printsmith/Greenwood18N2/README.md

# SP-110 Duo
Custom keyboard featuring a modified Southpaw 1800 layout with 2 nav clusters, LCD display and rotary encoders.
