printsmith/Greenwood18N2/SP110duo/dev/b2f16a65f4e9bf5dfcba937e58a7501a033d6607_switch.dxf

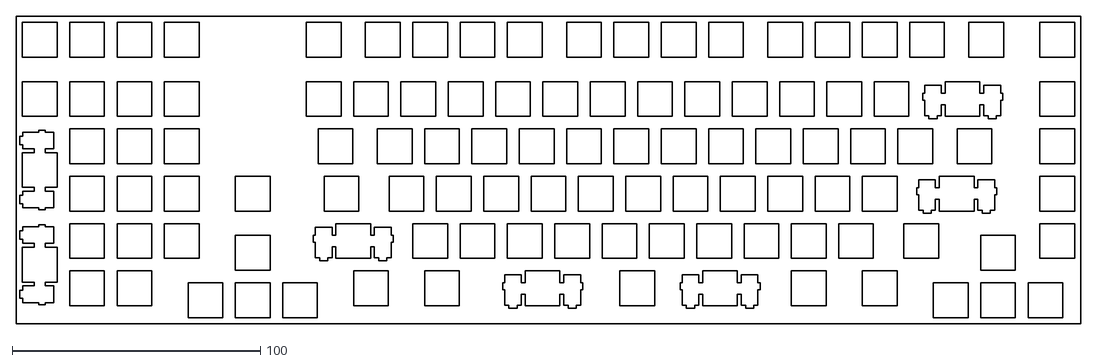
[picture p1: CAD file, 2023-11-25]
SP110duo/dev/b2f16a65f4e9bf5dfcba937e58a7501a033d6607_switch.dxf
428.6 x 123.8
