printsmith/Greenwood18N2/SP110duo/dev/CAD/plate.dxf

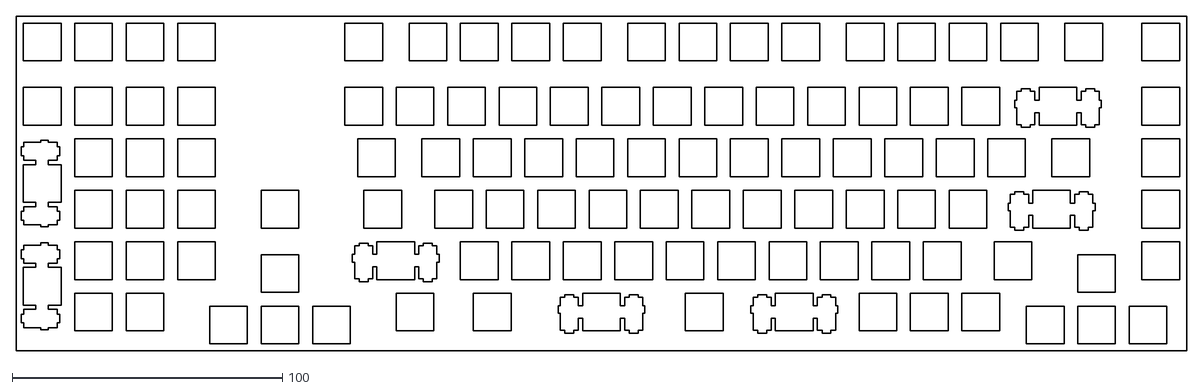
[picture p2: CAD file, 2023-12-18]
SP110duo/dev/CAD/plate.dxf
433.4 x 123.8
