printsmith/Greenwood18N2/SP110duo/dev/CAD/plate/plate-2023-11-30T22_32_08.672Z.dxf

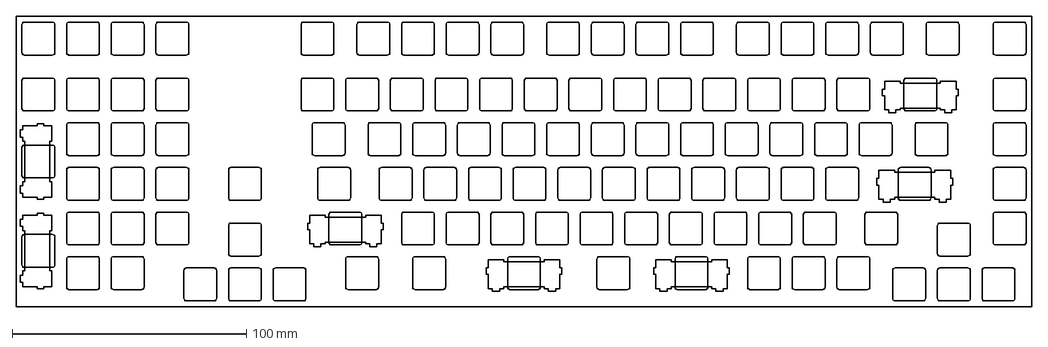
[picture p3: CAD file, 2023-12-18]
SP110duo/dev/CAD/plate/plate-2023-11-30T22_32_08.672Z.dxf
433.4 x 123.8 mm
