printsmith/Greenwood18N2/SP110duo/v1/SP110Duo.kicad_sch

## KiCad design SP110duo/v1/SP110Duo.kicad_sch (2024-02-24)

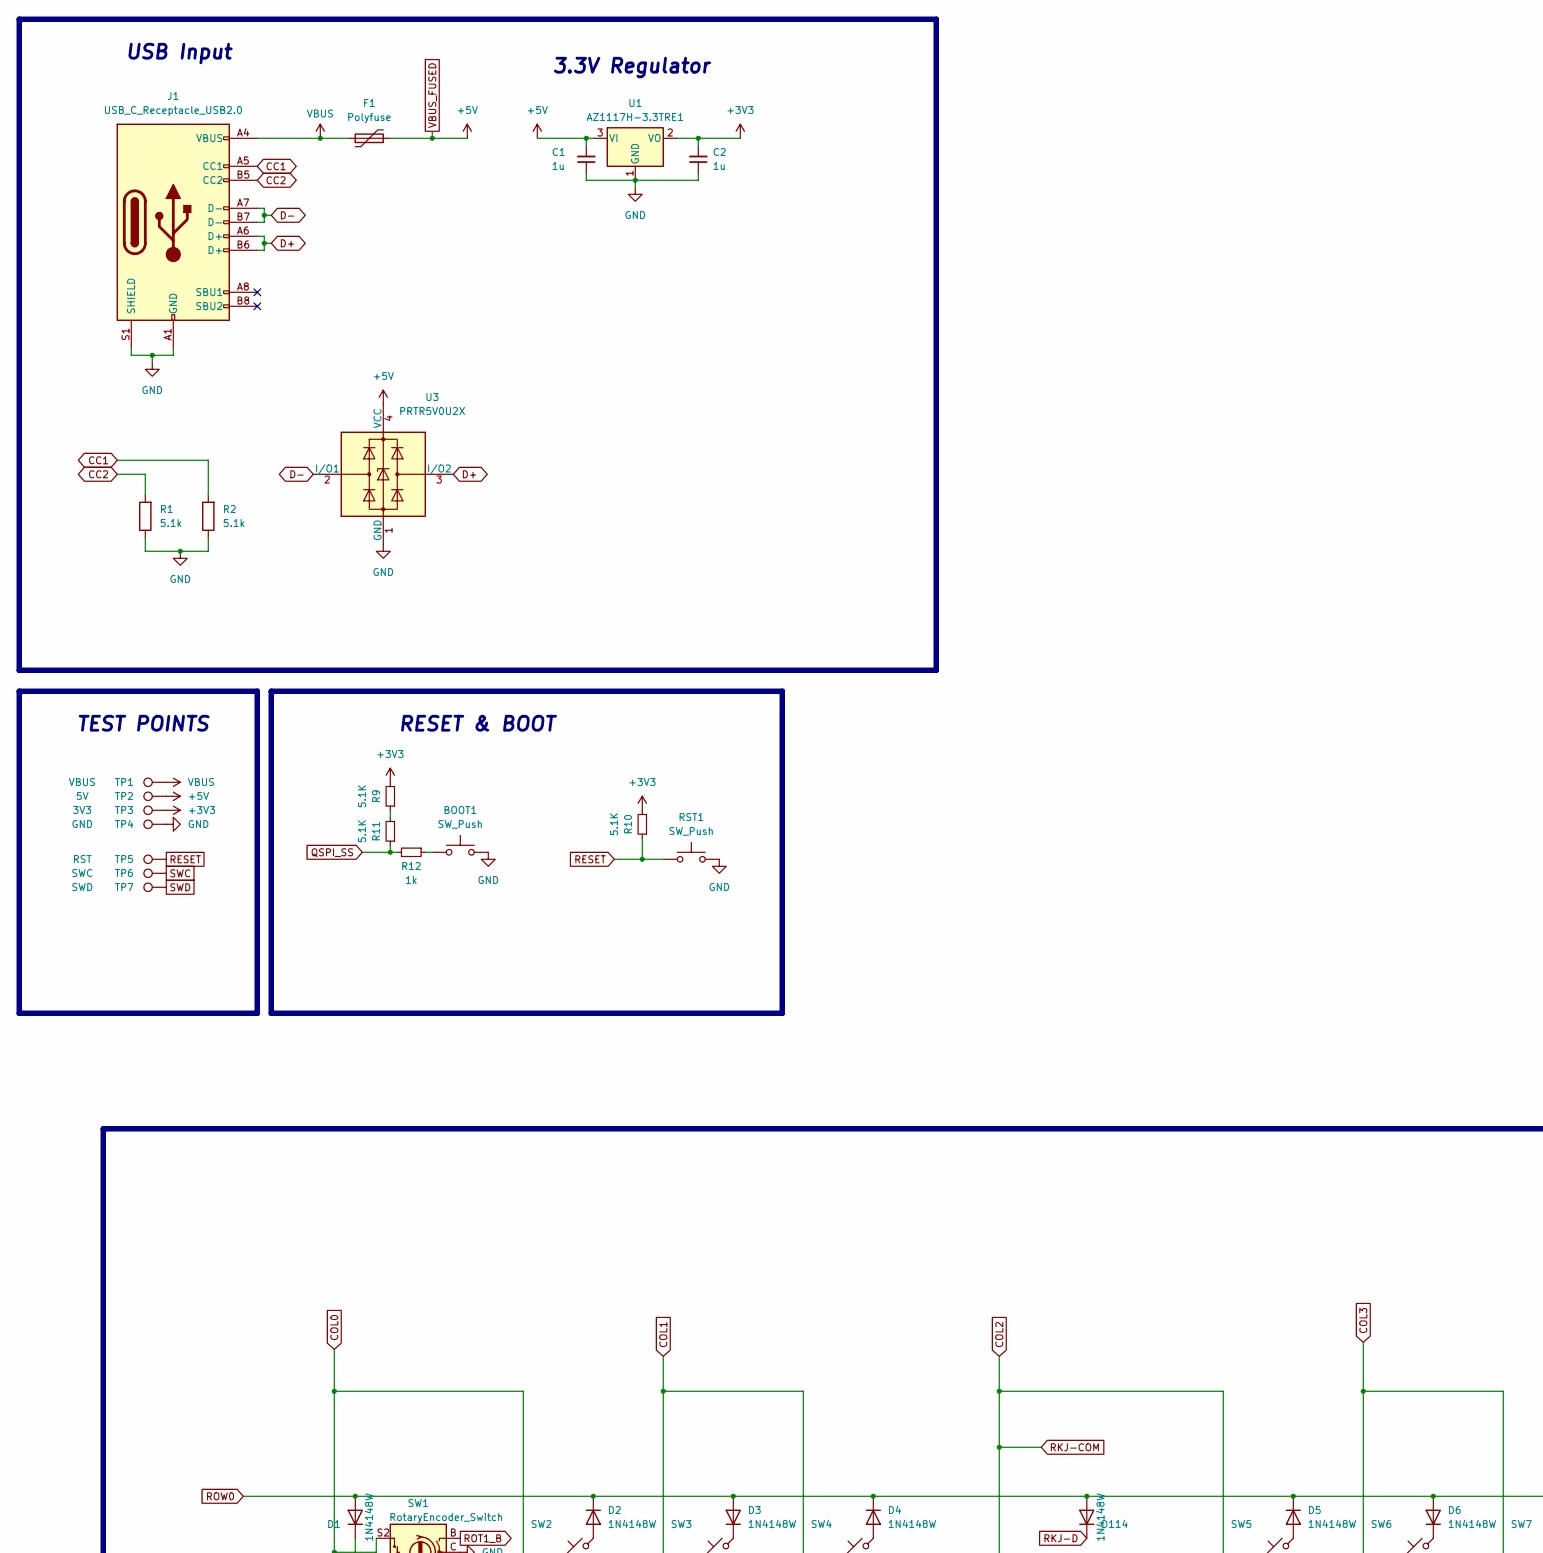
[picture p8: schematic SP110Duo.kicad_sch, part in row 1, column 1]

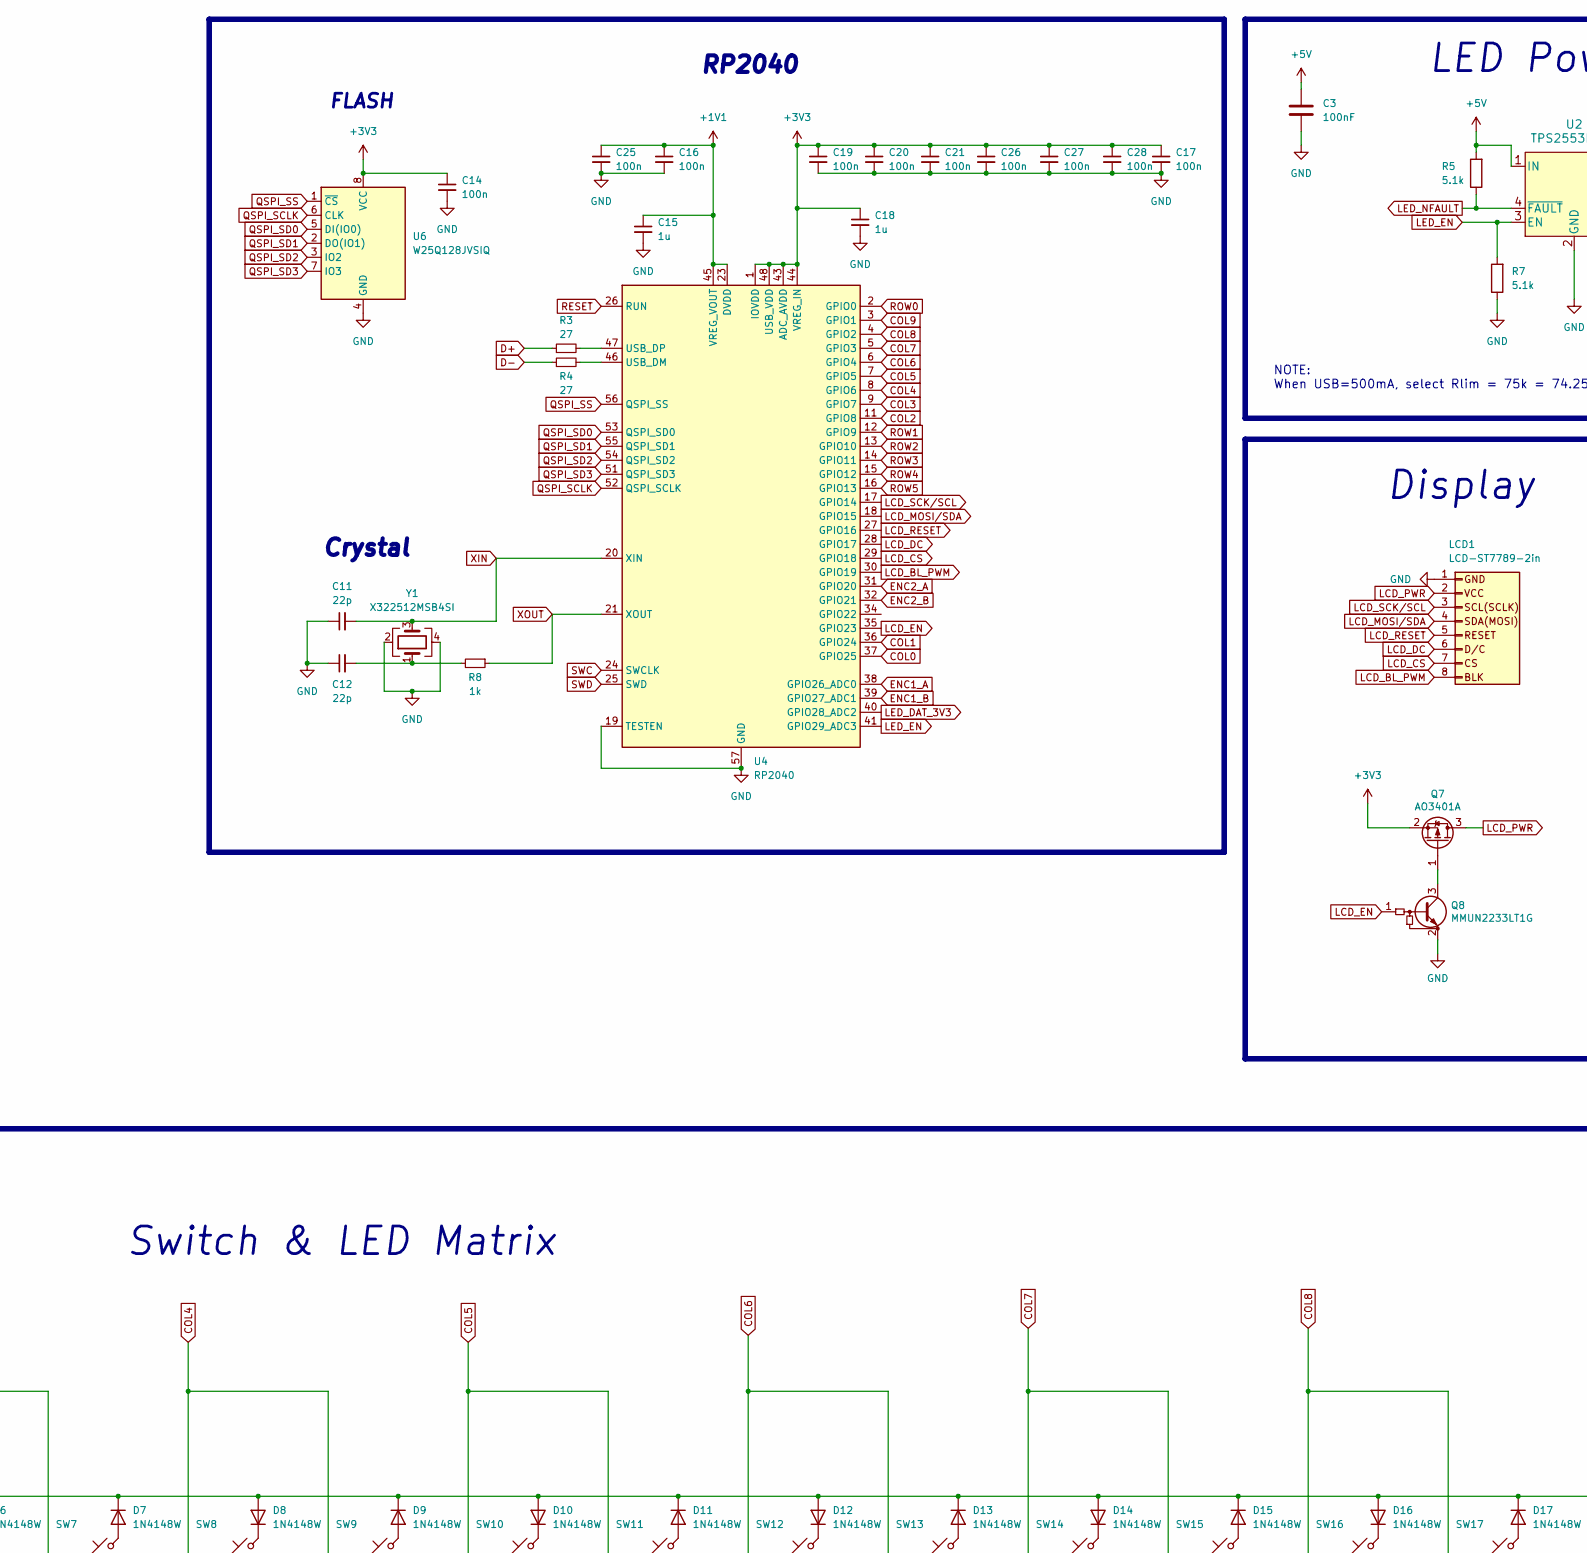
[picture p9: schematic SP110Duo.kicad_sch, part in row 1, column 2]

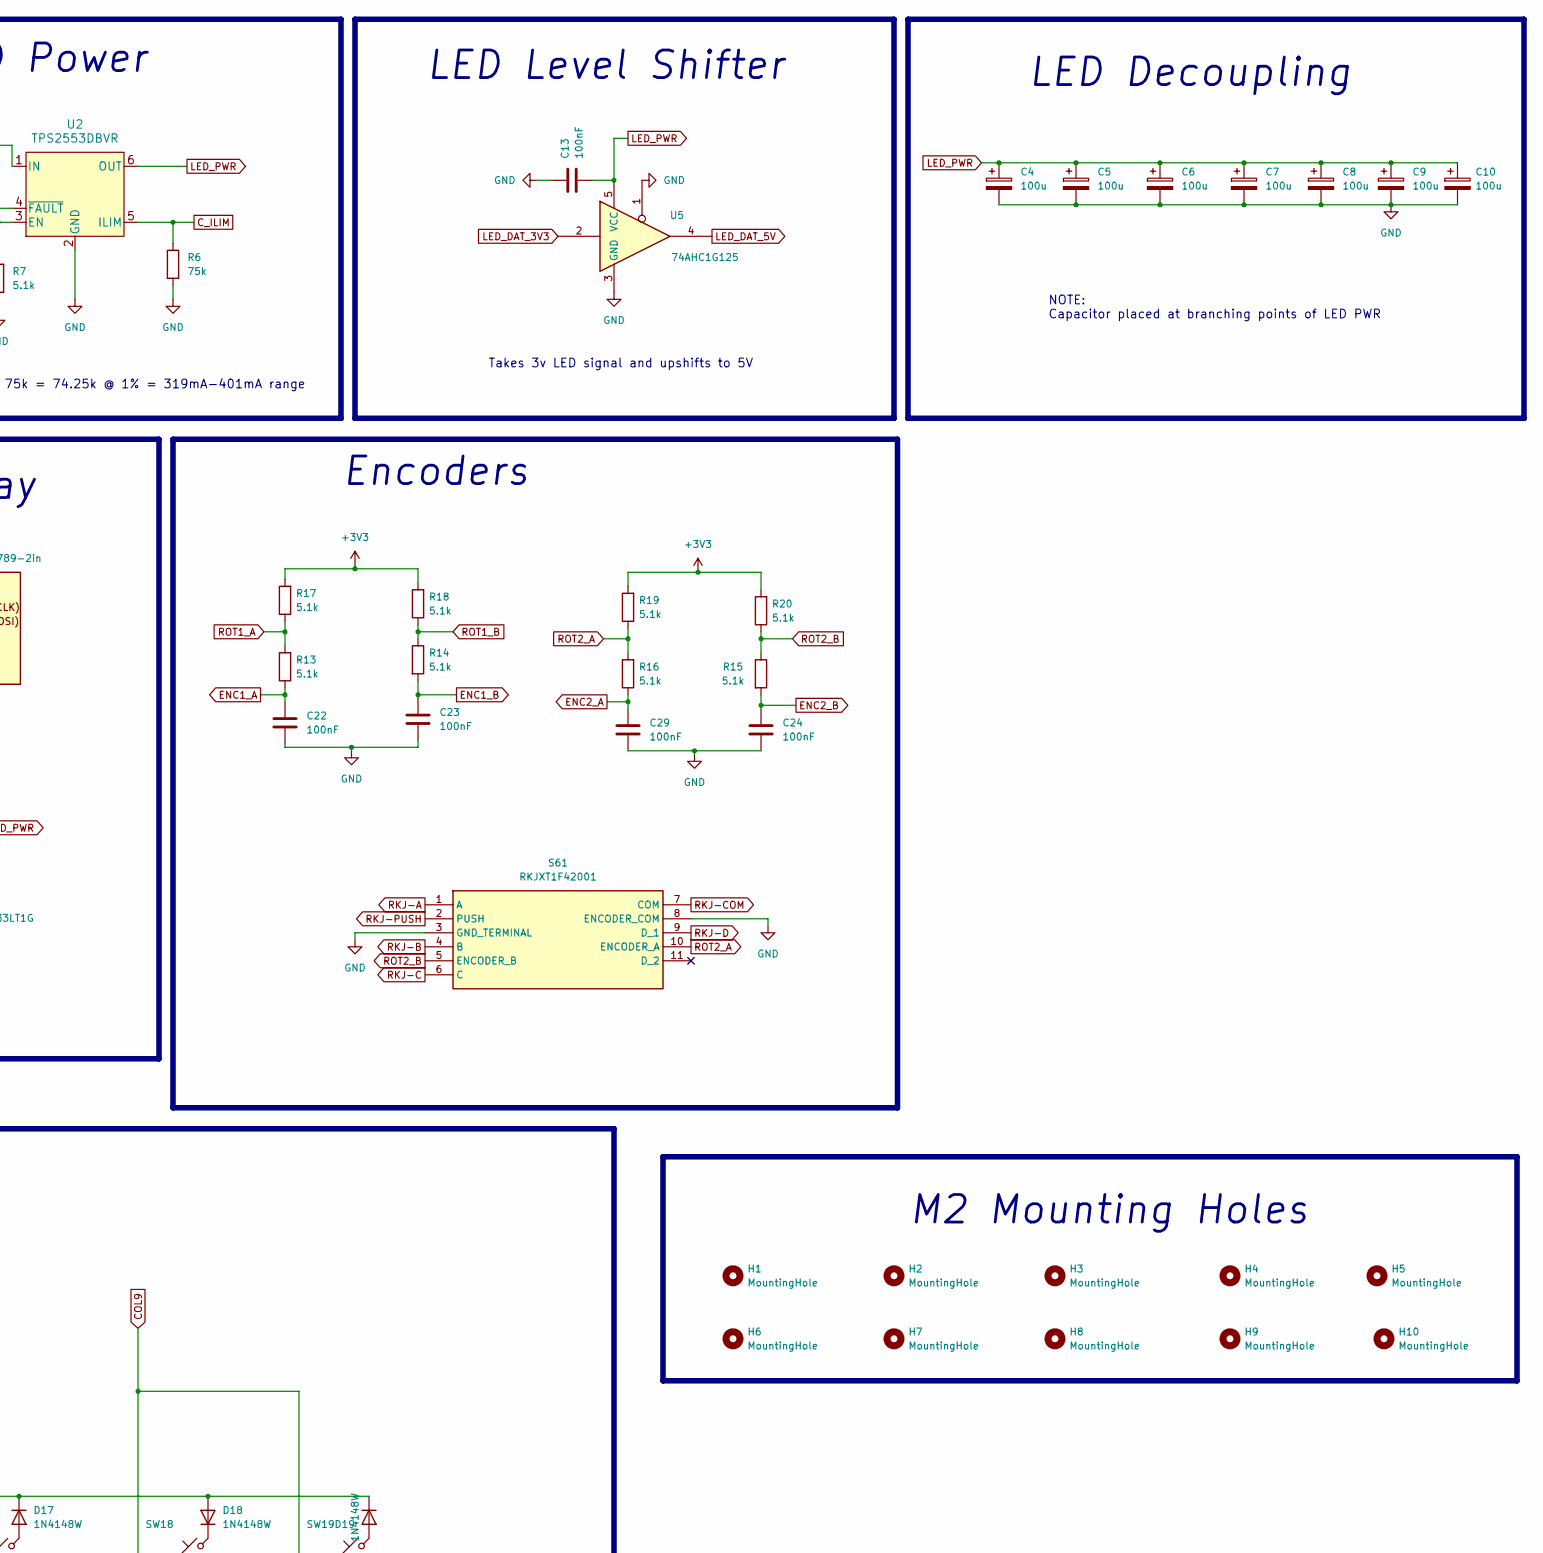
[picture p10: schematic SP110Duo.kicad_sch, part in row 1, column 3]

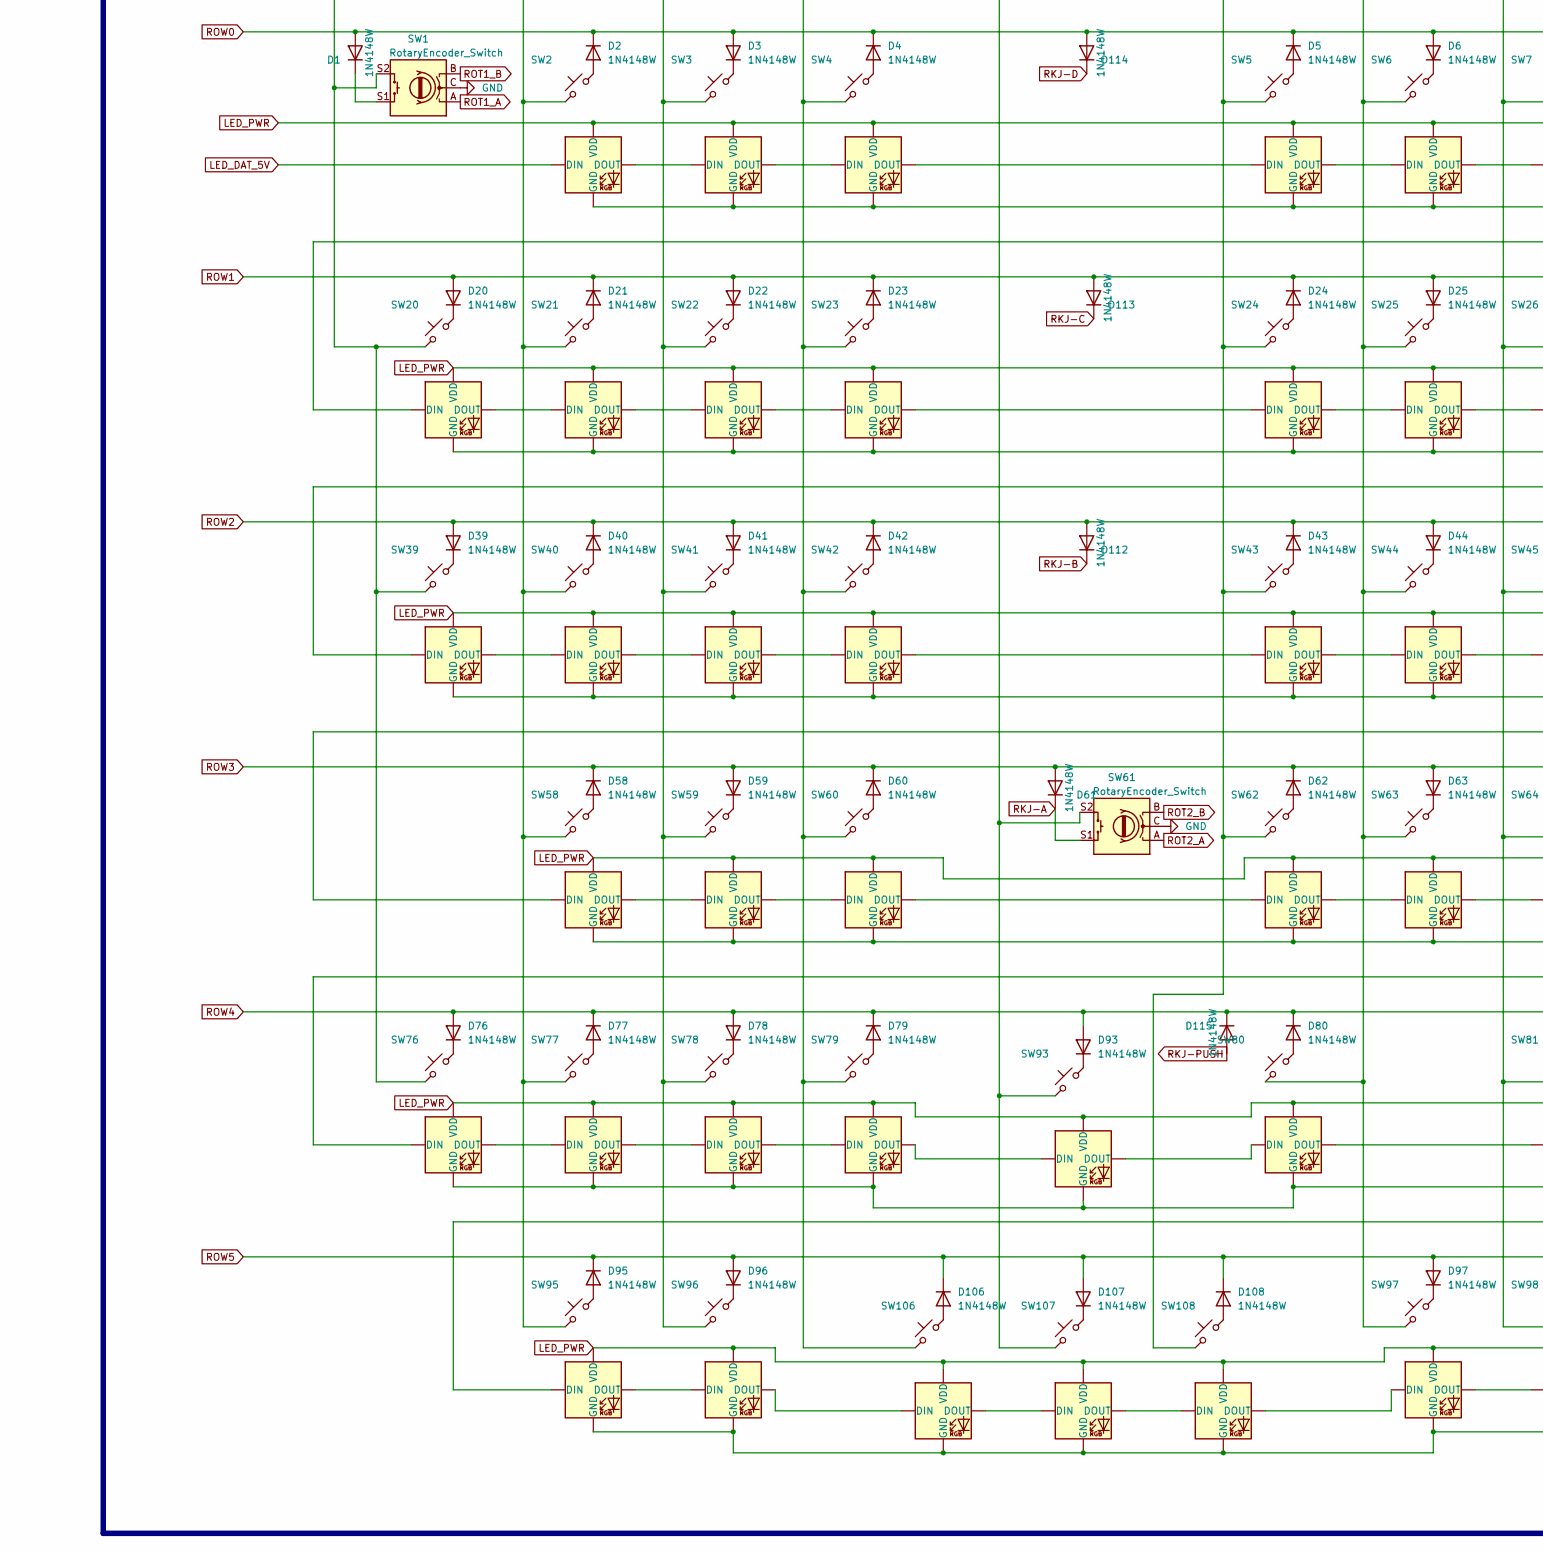
[picture p11: schematic SP110Duo.kicad_sch, part in row 2, column 1]

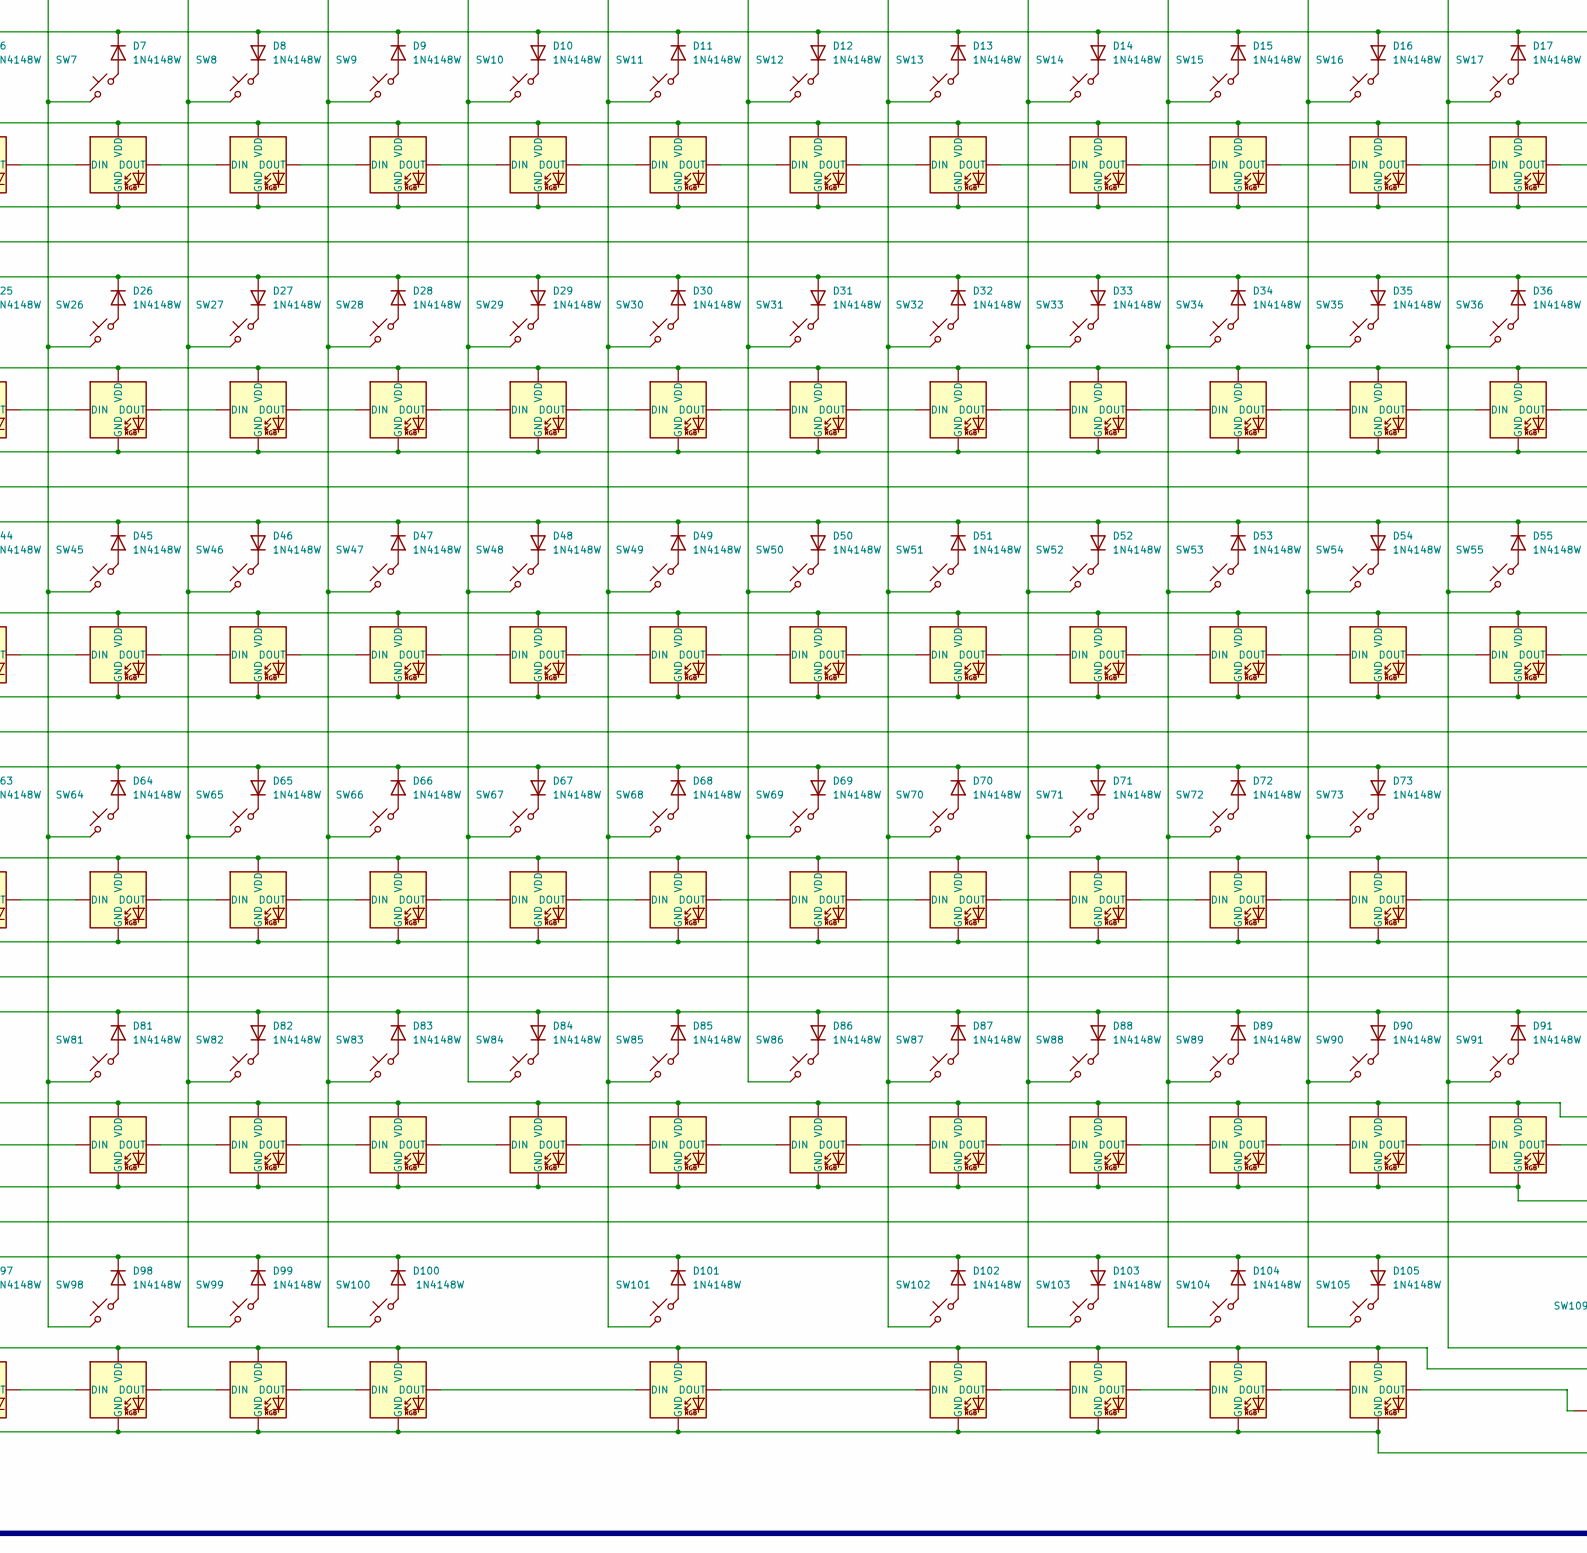
[picture p12: schematic SP110Duo.kicad_sch, part in row 2, column 2]

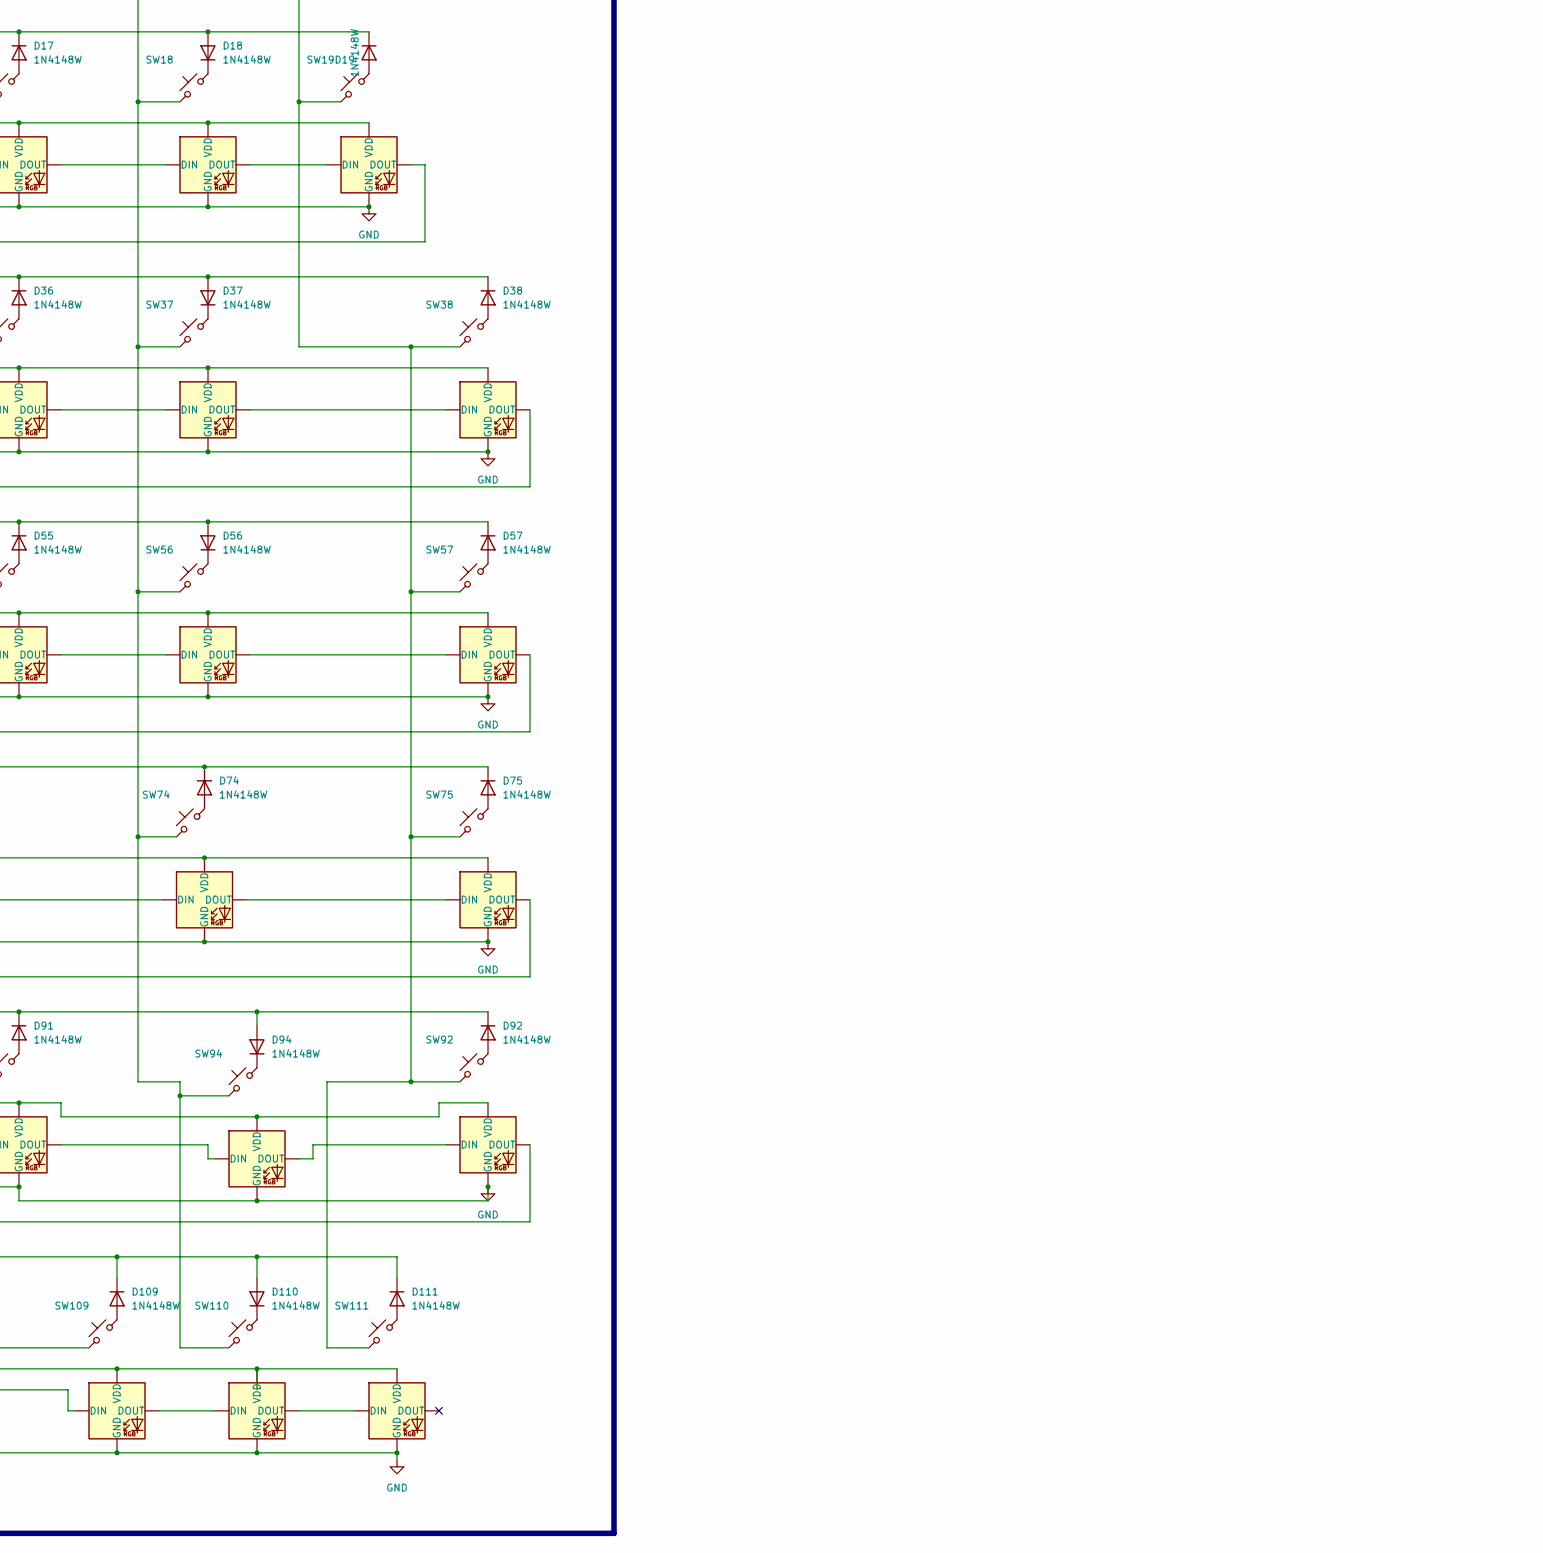
[picture p13: schematic SP110Duo.kicad_sch, part in row 2, column 3]

Parts:
BOOT1: SW_Push; SW_SPST_TL3342
C1, C2, C15, C18: 1u; C_0402_1005Metric
C3, C13: 100nF; C_0402_1005Metric
C4, C5, C6, C7, C8, C9, C10: 100u; CP_EIA-6032-15_Kemet-U
C11, C12: 22p; C_0402_1005Metric
C14, C16, C17, C19, C20, C21, C25, C26, C27, C28: 100n; C_0402_1005Metric
C22, C23, C24, C29: 100nF; C_0805_2012Metric
D1, D2, D3, D4, D5, D6, D7, D8, D9, D10, D11, D12, D13, D14, D15, D16, D17, D18, D19, D20, D21, D22, D23, D24, D25, D26, D27, D28, D29, D30, D31, D32, D33, D34, D35, D36, D37, D38, D39, D40, D41, D42, D43, D44, D45, D46, D47, D48, D49, D50, D51, D52, D53, D54, D55, D56, D57, D58, D59, D60, D61, D62, D63, D64, D65, D66, D67, D68, D69, D70, D71, D72, D73, D74, D75, D76, D77, D78, D79, D80, D81, D82, D83, D84, D85, D86, D87, D88, D89, D90, D91, D92, D93, D94, D95, D96, D97, D98, D99, D100, D101, D102, D103, D104, D105, D106, D107, D108, D109, D110, D111, D112, D113, D114, D115: 1N4148W; D_SOD-123
F1: Polyfuse; Fuse_1206_3216Metric_Pad1.42x1.75mm_HandSolder
H1, H2, H3, H4, H5, H6, H7, H8, H9, H10: MountingHole; MountingHole_2.2mm_M2_DIN965_Pad
J1: USB_C_Receptacle_USB2.0; HRO-TYPE-C-31-M-12-modded
LCD1: LCD-ST7789-2in
Q7: AO3401A; SOT-23-3
Q8: MMUN2233LT1G; SOT-23-3
R1, R2, R5, R7: 5.1k; R_0402_1005Metric
R3, R4: 27; R_0402_1005Metric
R6: 75k; R_0402_1005Metric
R8, R12: 1k; R_0402_1005Metric
R9, R10, R11: 5.1K; R_0402_1005Metric
R13, R14, R15, R16, R17, R18, R19, R20: 5.1k; R_0805_2012Metric
RST1: SW_Push; SW_SPST_TL3342
S61: RKJXT1F42001; Mouser Part Number 688-RKJXT1F42001
SW1, SW61: RotaryEncoder_Switch; RotaryEncoder_Alps_EC11E-Switch_Vertical_H20mm_Centred
SW2, SW3, SW4, SW5, SW6, SW7, SW8, SW9, SW10, SW11, SW12, SW13, SW14, SW15, SW16, SW17, SW18, SW19, SW20, SW21, SW22, SW23, SW24, SW25, SW26, SW27, SW28, SW29, SW30, SW31, SW32, SW33, SW34, SW35, SW36, SW38, SW40, SW41, SW42, SW44, SW45, SW46, SW47, SW48, SW49, SW50, SW51, SW52, SW53, SW54, SW55, SW57, SW58, SW59, SW60, SW63, SW64, SW65, SW66, SW67, SW68, SW69, SW70, SW71, SW72, SW73, SW75, SW77, SW78, SW79, SW81, SW82, SW83, SW84, SW85, SW86, SW87, SW88, SW89, SW90, SW92, SW93, SW94, SW95, SW103, SW104, SW105, SW106, SW107, SW108, SW109, SW110, SW111: Switch w/LED; Hotswap_MX_Plated_LED_1u
SW37, SW96: Switch w/LED; Hotswap_MX_Plated_LED_2u
SW39, SW76: Switch w/LED; Hotswap_MX_Plated_LED_2u_90deg
SW43, SW56: Switch w/LED; Hotswap_MX_Plated_LED_1.5u
SW62, SW91: Switch w/LED; Hotswap_MX_Plated_LED_1.75u
SW74, SW80, SW102: Switch w/LED; Hotswap_MX_Plated_LED_2.25u
SW97, SW98, SW99, SW101: Switch w/LED; Hotswap_MX_Plated_LED_1.25u
SW100: Switch w/LED; Hotswap_MX_Plated_LED_2.75u
TP1: VBUS; TestPoint
TP2: 5V; TestPoint
TP3: 3V3; TestPoint
TP4: GND; TestPoint
TP5: RST; TestPoint
TP6: SWC; TestPoint
TP7: SWD; TestPoint
U1: AZ1117H-3.3TRE1; SOT-223-3_TabPin2
U2: TPS2553DBVR; SOT-23-6
U3: PRTR5V0U2X; SOT-143_Handsoldering
U4: RP2040; QFN-56-1EP_7x7mm_P0.4mm_EP3.2x3.2mm
U5: 74AHC1G125; SOT-23-5
U6: W25Q128JVSIQ; SOIC-8_5.275x5.275mm_P1.27mm
Y1: X322512MSB4SI; Crystal_SMD_3225-4Pin_3.2x2.5mm

Connections:
+1V1: C15.1, C16.1, C25.1, U4.23 (DVDD), U4.45 (VREG_VOUT), U4.50 (DVDD)
+3V3: C2.2, C14.1, C17.1, C18.1, C19.1, C20.1, C21.1, C26.1, C27.1, C28.1, Q7.2 (S), R9.2, R10.2, R17.2, R18.2, R19.2, R20.2, TP3.1, U1.2 (VO), U4.1 (IOVDD), U4.10 (IOVDD), U4.22 (IOVDD), U4.33 (IOVDD), U4.42 (IOVDD), U4.43 (ADC_AVDD), U4.44 (VREG_IN), U4.48 (USB_VDD), U4.49 (IOVDD), U6.8 (VCC)
+5V: C1.2, C3.2, F1.2, R5.2, TP2.1, U1.3 (VI), U2.1 (IN), U3.4 (VCC)
CC1: J1.A5 (CC1), R2.2
CC2: J1.B5 (CC2), R1.2
COL0: SW1.S2, SW2.1, SW20.1, SW21.1, SW39.1, SW40.1, SW58.1, SW76.1, SW77.1, SW95.1, U4.37 (GPIO25)
COL1: SW3.1, SW4.1, SW22.1, SW23.1, SW41.1, SW42.1, SW59.1, SW60.1, SW78.1, SW79.1, SW96.1, SW106.1, U4.36 (GPIO24)
COL2: S61.7 (COM), SW5.1, SW24.1, SW43.1, SW61.S2, SW62.1, SW93.1, SW107.1, SW108.1, U4.11 (GPIO8)
COL3: SW6.1, SW7.1, SW25.1, SW26.1, SW44.1, SW45.1, SW63.1, SW64.1, SW80.1, SW81.1, SW97.1, SW98.1, U4.9 (GPIO7)
COL4: SW8.1, SW9.1, SW27.1, SW28.1, SW46.1, SW47.1, SW65.1, SW66.1, SW82.1, SW83.1, SW99.1, SW100.1, U4.8 (GPIO6)
COL5: SW10.1, SW11.1, SW29.1, SW30.1, SW48.1, SW49.1, SW67.1, SW68.1, SW84.1, SW85.1, SW101.1, U4.7 (GPIO5)
COL6: SW12.1, SW13.1, SW31.1, SW32.1, SW50.1, SW51.1, SW69.1, SW70.1, SW86.1, SW87.1, SW102.1, U4.6 (GPIO4)
COL7: SW14.1, SW15.1, SW33.1, SW34.1, SW52.1, SW53.1, SW71.1, SW72.1, SW88.1, SW89.1, SW103.1, SW104.1, U4.5 (GPIO3)
COL8: SW16.1, SW17.1, SW35.1, SW36.1, SW54.1, SW55.1, SW73.1, SW90.1, SW91.1, SW105.1, SW109.1, U4.4 (GPIO2)
COL9: SW18.1, SW19.1, SW37.1, SW38.1, SW56.1, SW57.1, SW74.1, SW75.1, SW92.1, SW94.1, SW110.1, SW111.1, U4.3 (GPIO1)
C_ILIM: R6.1, U2.5 (ILIM)
D+: J1.A6 (D+), J1.B6 (D+), R3.1, U3.3 (I/O2)
D-: J1.A7 (D-), J1.B7 (D-), R4.1, U3.2 (I/O1)
ENC1_A: C22.2, R13.1, U4.38 (GPIO26_ADC0)
ENC1_B: C23.2, R14.2, U4.39 (GPIO27_ADC1)
ENC2_A: C29.2, R16.1, U4.31 (GPIO20)
ENC2_B: C24.2, R15.2, U4.32 (GPIO21)
GND: BOOT1.2, C1.1, C2.1, C3.1, C4.2, C5.2, C6.2, C7.2, C8.2, C9.2, C10.2, C11.1, C12.1, C13.2, C14.2, C15.2, C16.2, C17.2, C18.2, C19.2, C20.2, C21.2, C22.1, C23.1, C24.1, C25.2, C26.2, C27.2, C28.2, C29.1, J1.A1 (GND), J1.A12 (GND), J1.B1 (GND), J1.B12 (GND), J1.S1 (SHIELD), LCD1.1, Q8.2 (E), R1.1, R2.1, R6.2, R7.1, RST1.2, S61.3 (GND_TERMINAL), S61.8 (ENCODER_COM), SW1.C, SW2.6 (GND), SW3.6 (GND), SW4.6 (GND), SW5.6 (GND), SW6.6 (GND), SW7.6 (GND), SW8.6 (GND), SW9.6 (GND), SW10.6 (GND), SW11.6 (GND), SW12.6 (GND), SW13.6 (GND), SW14.6 (GND), SW15.6 (GND), SW16.6 (GND), SW17.6 (GND), SW18.6 (GND), SW19.6 (GND), SW20.6 (GND), SW21.6 (GND), SW22.6 (GND), SW23.6 (GND), SW24.6 (GND), SW25.6 (GND), SW26.6 (GND), SW27.6 (GND), SW28.6 (GND), SW29.6 (GND), SW30.6 (GND), SW31.6 (GND), SW32.6 (GND), SW33.6 (GND), SW34.6 (GND), SW35.6 (GND), SW36.6 (GND), SW37.6 (GND), SW38.6 (GND), SW39.6 (GND), SW40.6 (GND), SW41.6 (GND), SW42.6 (GND), SW43.6 (GND), SW44.6 (GND), SW45.6 (GND), SW46.6 (GND), SW47.6 (GND), SW48.6 (GND), SW49.6 (GND), SW50.6 (GND), SW51.6 (GND), SW52.6 (GND), SW53.6 (GND), SW54.6 (GND), SW55.6 (GND), SW56.6 (GND), SW57.6 (GND), SW58.6 (GND), SW59.6 (GND), SW60.6 (GND), SW61.C, SW62.6 (GND), SW63.6 (GND), SW64.6 (GND), SW65.6 (GND), SW66.6 (GND), SW67.6 (GND), SW68.6 (GND), SW69.6 (GND), SW70.6 (GND), SW71.6 (GND), SW72.6 (GND), SW73.6 (GND), SW74.6 (GND), SW75.6 (GND), SW76.6 (GND), SW77.6 (GND), SW78.6 (GND), SW79.6 (GND), SW80.6 (GND), SW81.6 (GND), SW82.6 (GND), SW83.6 (GND), SW84.6 (GND), SW85.6 (GND), SW86.6 (GND), SW87.6 (GND), SW88.6 (GND), SW89.6 (GND), SW90.6 (GND), SW91.6 (GND), SW92.6 (GND), SW93.6 (GND), SW94.6 (GND), SW95.6 (GND), SW96.6 (GND), SW97.6 (GND), SW98.6 (GND), SW99.6 (GND), SW100.6 (GND), SW101.6 (GND), SW102.6 (GND), SW103.6 (GND), SW104.6 (GND), SW105.6 (GND), SW106.6 (GND), SW107.6 (GND), SW108.6 (GND), SW109.6 (GND), SW110.6 (GND), SW111.6 (GND), TP4.1, U1.1 (GND), U2.2 (GND), U3.1 (GND), U4.19 (TESTEN), U4.57 (GND), U5.1, U5.3 (GND), U6.4 (GND), Y1.2, Y1.4
LCD_BL_PWM: LCD1.8, U4.30 (GPIO19)
LCD_CS: LCD1.7, U4.29 (GPIO18)
LCD_DC: LCD1.6, U4.28 (GPIO17)
LCD_EN: Q8.1 (B), U4.35 (GPIO23)
LCD_MOSI/SDA: LCD1.4, U4.18 (GPIO15)
LCD_PWR: LCD1.2, Q7.3 (D)
LCD_RESET: LCD1.5, U4.27 (GPIO16)
LCD_SCK/SCL: LCD1.3, U4.17 (GPIO14)
LED_DAT_3V3: U4.40 (GPIO28_ADC2), U5.2
LED_DAT_5V: SW2.5 (DIN), U5.4
LED_EN: R7.2, U2.3 (EN), U4.41 (GPIO29_ADC3)
LED_NFAULT: R5.1, U2.4 (~FAULT)
LED_PWR: C4.1, C5.1, C6.1, C7.1, C8.1, C9.1, C10.1, C13.1, SW2.3 (VDD), SW3.3 (VDD), SW4.3 (VDD), SW5.3 (VDD), SW6.3 (VDD), SW7.3 (VDD), SW8.3 (VDD), SW9.3 (VDD), SW10.3 (VDD), SW11.3 (VDD), SW12.3 (VDD), SW13.3 (VDD), SW14.3 (VDD), SW15.3 (VDD), SW16.3 (VDD), SW17.3 (VDD), SW18.3 (VDD), SW19.3 (VDD), SW20.3 (VDD), SW21.3 (VDD), SW22.3 (VDD), SW23.3 (VDD), SW24.3 (VDD), SW25.3 (VDD), SW26.3 (VDD), SW27.3 (VDD), SW28.3 (VDD), SW29.3 (VDD), SW30.3 (VDD), SW31.3 (VDD), SW32.3 (VDD), SW33.3 (VDD), SW34.3 (VDD), SW35.3 (VDD), SW36.3 (VDD), SW37.3 (VDD), SW38.3 (VDD), SW39.3 (VDD), SW40.3 (VDD), SW41.3 (VDD), SW42.3 (VDD), SW43.3 (VDD), SW44.3 (VDD), SW45.3 (VDD), SW46.3 (VDD), SW47.3 (VDD), SW48.3 (VDD), SW49.3 (VDD), SW50.3 (VDD), SW51.3 (VDD), SW52.3 (VDD), SW53.3 (VDD), SW54.3 (VDD), SW55.3 (VDD), SW56.3 (VDD), SW57.3 (VDD), SW58.3 (VDD), SW59.3 (VDD), SW60.3 (VDD), SW62.3 (VDD), SW63.3 (VDD), SW64.3 (VDD), SW65.3 (VDD), SW66.3 (VDD), SW67.3 (VDD), SW68.3 (VDD), SW69.3 (VDD), SW70.3 (VDD), SW71.3 (VDD), SW72.3 (VDD), SW73.3 (VDD), SW74.3 (VDD), SW75.3 (VDD), SW76.3 (VDD), SW77.3 (VDD), SW78.3 (VDD), SW79.3 (VDD), SW80.3 (VDD), SW81.3 (VDD), SW82.3 (VDD), SW83.3 (VDD), SW84.3 (VDD), SW85.3 (VDD), SW86.3 (VDD), SW87.3 (VDD), SW88.3 (VDD), SW89.3 (VDD), SW90.3 (VDD), SW91.3 (VDD), SW92.3 (VDD), SW93.3 (VDD), SW94.3 (VDD), SW95.3 (VDD), SW96.3 (VDD), SW97.3 (VDD), SW98.3 (VDD), SW99.3 (VDD), SW100.3 (VDD), SW101.3 (VDD), SW102.3 (VDD), SW103.3 (VDD), SW104.3 (VDD), SW105.3 (VDD), SW106.3 (VDD), SW107.3 (VDD), SW108.3 (VDD), SW109.3 (VDD), SW110.3 (VDD), SW111.3 (VDD), U2.6 (OUT), U5.5 (VCC)
unnamed: BOOT1.1, R12.1
unnamed: C12.2, R8.2, Y1.1
unnamed: D1.1 (K), SW1.S1
unnamed: D2.2 (A), SW2.2
unnamed: D3.1 (K), SW3.2
unnamed: D4.2 (A), SW4.2
unnamed: D5.2 (A), SW5.2
unnamed: D6.1 (K), SW6.2
unnamed: D7.2 (A), SW7.2
unnamed: D8.1 (K), SW8.2
unnamed: D9.2 (A), SW9.2
unnamed: D10.1 (K), SW10.2
unnamed: D11.2 (A), SW11.2
unnamed: D12.1 (K), SW12.2
unnamed: D13.2 (A), SW13.2
unnamed: D14.1 (K), SW14.2
unnamed: D15.2 (A), SW15.2
unnamed: D16.1 (K), SW16.2
unnamed: D17.2 (A), SW17.2
unnamed: D18.1 (K), SW18.2
unnamed: D19.2 (A), SW19.2
unnamed: D20.1 (K), SW20.2
unnamed: D21.2 (A), SW21.2
unnamed: D22.1 (K), SW22.2
unnamed: D23.2 (A), SW23.2
unnamed: D24.2 (A), SW24.2
unnamed: D25.1 (K), SW25.2
unnamed: D26.2 (A), SW26.2
unnamed: D27.1 (K), SW27.2
unnamed: D28.2 (A), SW28.2
unnamed: D29.1 (K), SW29.2
unnamed: D30.2 (A), SW30.2
unnamed: D31.1 (K), SW31.2
unnamed: D32.2 (A), SW32.2
unnamed: D33.1 (K), SW33.2
unnamed: D34.2 (A), SW34.2
unnamed: D35.1 (K), SW35.2
unnamed: D36.2 (A), SW36.2
unnamed: D37.1 (K), SW37.2
unnamed: D38.2 (A), SW38.2
unnamed: D39.1 (K), SW39.2
unnamed: D40.2 (A), SW40.2
unnamed: D41.1 (K), SW41.2
unnamed: D42.2 (A), SW42.2
unnamed: D43.2 (A), SW43.2
unnamed: D44.1 (K), SW44.2
unnamed: D45.2 (A), SW45.2
unnamed: D46.1 (K), SW46.2
unnamed: D47.2 (A), SW47.2
unnamed: D48.1 (K), SW48.2
unnamed: D49.2 (A), SW49.2
unnamed: D50.1 (K), SW50.2
unnamed: D51.2 (A), SW51.2
unnamed: D52.1 (K), SW52.2
unnamed: D53.2 (A), SW53.2
unnamed: D54.1 (K), SW54.2
unnamed: D55.2 (A), SW55.2
unnamed: D56.1 (K), SW56.2
unnamed: D57.2 (A), SW57.2
unnamed: D58.2 (A), SW58.2
unnamed: D59.1 (K), SW59.2
unnamed: D60.2 (A), SW60.2
unnamed: D62.2 (A), SW62.2
unnamed: D63.1 (K), SW63.2
unnamed: D64.2 (A), SW64.2
unnamed: D65.1 (K), SW65.2
unnamed: D66.2 (A), SW66.2
unnamed: D67.1 (K), SW67.2
unnamed: D68.2 (A), SW68.2
unnamed: D69.1 (K), SW69.2
unnamed: D70.2 (A), SW70.2
unnamed: D71.1 (K), SW71.2
unnamed: D72.2 (A), SW72.2
unnamed: D73.1 (K), SW73.2
unnamed: D74.2 (A), SW74.2
unnamed: D75.2 (A), SW75.2
unnamed: D76.1 (K), SW76.2
unnamed: D77.2 (A), SW77.2
unnamed: D78.1 (K), SW78.2
unnamed: D79.2 (A), SW79.2
unnamed: D80.2 (A), SW80.2
unnamed: D81.2 (A), SW81.2
unnamed: D82.1 (K), SW82.2
unnamed: D83.2 (A), SW83.2
unnamed: D84.1 (K), SW84.2
unnamed: D85.2 (A), SW85.2
unnamed: D86.1 (K), SW86.2
unnamed: D87.2 (A), SW87.2
unnamed: D88.1 (K), SW88.2
unnamed: D89.2 (A), SW89.2
unnamed: D90.1 (K), SW90.2
unnamed: D91.2 (A), SW91.2
unnamed: D92.2 (A), SW92.2
unnamed: D93.1 (K), SW93.2
unnamed: D94.1 (K), SW94.2
unnamed: D95.2 (A), SW95.2
unnamed: D96.1 (K), SW96.2
unnamed: D97.1 (K), SW97.2
unnamed: D98.2 (A), SW98.2
unnamed: D99.2 (A), SW99.2
unnamed: D100.2 (A), SW100.2
unnamed: D101.2 (A), SW101.2
unnamed: D102.2 (A), SW102.2
unnamed: D103.1 (K), SW103.2
unnamed: D104.2 (A), SW104.2
unnamed: D105.1 (K), SW105.2
unnamed: D106.2 (A), SW106.2
unnamed: D107.1 (K), SW107.2
unnamed: D108.2 (A), SW108.2
unnamed: D109.2 (A), SW109.2
unnamed: D110.1 (K), SW110.2
unnamed: D111.2 (A), SW111.2
unnamed: Q7.1 (G), Q8.3 (C)
unnamed: R3.2, U4.47 (USB_DP)
unnamed: R4.2, U4.46 (USB_DM)
unnamed: R9.1, R11.2
unnamed: SW2.4 (DOUT), SW3.5 (DIN)
unnamed: SW3.4 (DOUT), SW4.5 (DIN)
unnamed: SW4.4 (DOUT), SW5.5 (DIN)
unnamed: SW5.4 (DOUT), SW6.5 (DIN)
unnamed: SW6.4 (DOUT), SW7.5 (DIN)
unnamed: SW7.4 (DOUT), SW8.5 (DIN)
unnamed: SW8.4 (DOUT), SW9.5 (DIN)
unnamed: SW10.4 (DOUT), SW11.5 (DIN)
unnamed: SW9.4 (DOUT), SW10.5 (DIN)
unnamed: SW11.4 (DOUT), SW12.5 (DIN)
unnamed: SW12.4 (DOUT), SW13.5 (DIN)
unnamed: SW13.4 (DOUT), SW14.5 (DIN)
unnamed: SW14.4 (DOUT), SW15.5 (DIN)
unnamed: SW15.4 (DOUT), SW16.5 (DIN)
unnamed: SW16.4 (DOUT), SW17.5 (DIN)
unnamed: SW17.4 (DOUT), SW18.5 (DIN)
unnamed: SW18.4 (DOUT), SW19.5 (DIN)
unnamed: SW19.4 (DOUT), SW20.5 (DIN)
unnamed: SW20.4 (DOUT), SW21.5 (DIN)
unnamed: SW21.4 (DOUT), SW22.5 (DIN)
unnamed: SW22.4 (DOUT), SW23.5 (DIN)
unnamed: SW23.4 (DOUT), SW24.5 (DIN)
unnamed: SW24.4 (DOUT), SW25.5 (DIN)
unnamed: SW25.4 (DOUT), SW26.5 (DIN)
unnamed: SW26.4 (DOUT), SW27.5 (DIN)
unnamed: SW27.4 (DOUT), SW28.5 (DIN)
unnamed: SW28.4 (DOUT), SW29.5 (DIN)
unnamed: SW29.4 (DOUT), SW30.5 (DIN)
unnamed: SW30.4 (DOUT), SW31.5 (DIN)
unnamed: SW31.4 (DOUT), SW32.5 (DIN)
unnamed: SW32.4 (DOUT), SW33.5 (DIN)
unnamed: SW33.4 (DOUT), SW34.5 (DIN)
unnamed: SW34.4 (DOUT), SW35.5 (DIN)
unnamed: SW35.4 (DOUT), SW36.5 (DIN)
unnamed: SW36.4 (DOUT), SW37.5 (DIN)
unnamed: SW37.4 (DOUT), SW38.5 (DIN)
unnamed: SW38.4 (DOUT), SW39.5 (DIN)
unnamed: SW39.4 (DOUT), SW40.5 (DIN)
unnamed: SW40.4 (DOUT), SW41.5 (DIN)
unnamed: SW41.4 (DOUT), SW42.5 (DIN)
unnamed: SW42.4 (DOUT), SW43.5 (DIN)
unnamed: SW43.4 (DOUT), SW44.5 (DIN)
unnamed: SW44.4 (DOUT), SW45.5 (DIN)
unnamed: SW45.4 (DOUT), SW46.5 (DIN)
unnamed: SW46.4 (DOUT), SW47.5 (DIN)
unnamed: SW47.4 (DOUT), SW48.5 (DIN)
unnamed: SW48.4 (DOUT), SW49.5 (DIN)
unnamed: SW49.4 (DOUT), SW50.5 (DIN)
unnamed: SW50.4 (DOUT), SW51.5 (DIN)
unnamed: SW51.4 (DOUT), SW52.5 (DIN)
unnamed: SW52.4 (DOUT), SW53.5 (DIN)
unnamed: SW53.4 (DOUT), SW54.5 (DIN)
unnamed: SW54.4 (DOUT), SW55.5 (DIN)
unnamed: SW55.4 (DOUT), SW56.5 (DIN)
unnamed: SW56.4 (DOUT), SW57.5 (DIN)
unnamed: SW57.4 (DOUT), SW58.5 (DIN)
unnamed: SW58.4 (DOUT), SW59.5 (DIN)
unnamed: SW59.4 (DOUT), SW60.5 (DIN)
unnamed: SW60.4 (DOUT), SW62.5 (DIN)
unnamed: SW62.4 (DOUT), SW63.5 (DIN)
unnamed: SW63.4 (DOUT), SW64.5 (DIN)
unnamed: SW64.4 (DOUT), SW65.5 (DIN)
unnamed: SW65.4 (DOUT), SW66.5 (DIN)
unnamed: SW66.4 (DOUT), SW67.5 (DIN)
unnamed: SW67.4 (DOUT), SW68.5 (DIN)
unnamed: SW68.4 (DOUT), SW69.5 (DIN)
unnamed: SW69.4 (DOUT), SW70.5 (DIN)
unnamed: SW70.4 (DOUT), SW71.5 (DIN)
unnamed: SW71.4 (DOUT), SW72.5 (DIN)
unnamed: SW72.4 (DOUT), SW73.5 (DIN)
unnamed: SW73.4 (DOUT), SW74.5 (DIN)
unnamed: SW74.4 (DOUT), SW75.5 (DIN)
unnamed: SW75.4 (DOUT), SW76.5 (DIN)
unnamed: SW76.4 (DOUT), SW77.5 (DIN)
unnamed: SW77.4 (DOUT), SW78.5 (DIN)
unnamed: SW78.4 (DOUT), SW79.5 (DIN)
unnamed: SW79.4 (DOUT), SW93.5 (DIN)
unnamed: SW80.4 (DOUT), SW81.5 (DIN)
unnamed: SW80.5 (DIN), SW93.4 (DOUT)
unnamed: SW81.4 (DOUT), SW82.5 (DIN)
unnamed: SW82.4 (DOUT), SW83.5 (DIN)
unnamed: SW83.4 (DOUT), SW84.5 (DIN)
unnamed: SW84.4 (DOUT), SW85.5 (DIN)
unnamed: SW85.4 (DOUT), SW86.5 (DIN)
unnamed: SW86.4 (DOUT), SW87.5 (DIN)
unnamed: SW87.4 (DOUT), SW88.5 (DIN)
unnamed: SW88.4 (DOUT), SW89.5 (DIN)
unnamed: SW89.4 (DOUT), SW90.5 (DIN)
unnamed: SW90.4 (DOUT), SW91.5 (DIN)
unnamed: SW91.4 (DOUT), SW94.5 (DIN)
unnamed: SW92.4 (DOUT), SW95.5 (DIN)
unnamed: SW92.5 (DIN), SW94.4 (DOUT)
unnamed: SW95.4 (DOUT), SW96.5 (DIN)
unnamed: SW97.4 (DOUT), SW98.5 (DIN)
unnamed: SW98.4 (DOUT), SW99.5 (DIN)
unnamed: SW100.4 (DOUT), SW101.5 (DIN)
unnamed: SW99.4 (DOUT), SW100.5 (DIN)
unnamed: SW101.4 (DOUT), SW102.5 (DIN)
unnamed: SW102.4 (DOUT), SW103.5 (DIN)
unnamed: SW103.4 (DOUT), SW104.5 (DIN)
unnamed: SW104.4 (DOUT), SW105.5 (DIN)
unnamed: SW105.4 (DOUT), SW109.5 (DIN)
unnamed: SW106.4 (DOUT), SW107.5 (DIN)
unnamed: SW96.4 (DOUT), SW106.5 (DIN)
unnamed: SW107.4 (DOUT), SW108.5 (DIN)
unnamed: SW97.5 (DIN), SW108.4 (DOUT)
unnamed: SW109.4 (DOUT), SW110.5 (DIN)
unnamed: SW110.4 (DOUT), SW111.5 (DIN)
QSPI_SCLK: U4.52 (QSPI_SCLK), U6.6 (CLK)
QSPI_SD0: U4.53 (QSPI_SD0), U6.5 (DI(IO0))
QSPI_SD1: U4.55 (QSPI_SD1), U6.2 (DO(IO1))
QSPI_SD2: U4.54 (QSPI_SD2), U6.3 (IO2)
QSPI_SD3: U4.51 (QSPI_SD3), U6.7 (IO3)
QSPI_SS: R11.1, R12.2, U4.56 (QSPI_SS), U6.1 (~CS)
RESET: R10.1, RST1.1, TP5.1, U4.26 (RUN)
RKJ-A: D61.1 (K), S61.1 (A), SW61.S1
RKJ-B: D112.1 (K), S61.4 (B)
RKJ-C: D113.1 (K), S61.6 (C)
RKJ-D: D114.1 (K), S61.9 (D_1)
RKJ-PUSH: D115.2 (A), S61.2 (PUSH)
ROT1_A: R13.2, R17.1, SW1.A
ROT1_B: R14.1, R18.1, SW1.B
ROT2_A: R16.2, R19.1, S61.10 (ENCODER_A), SW61.A
ROT2_B: R15.1, R20.1, S61.5 (ENCODER_B), SW61.B
ROW0: D1.2 (A), D2.1 (K), D3.2 (A), D4.1 (K), D5.1 (K), D6.2 (A), D7.1 (K), D8.2 (A), D9.1 (K), D10.2 (A), D11.1 (K), D12.2 (A), D13.1 (K), D14.2 (A), D15.1 (K), D16.2 (A), D17.1 (K), D18.2 (A), D19.1 (K), D114.2 (A), U4.2 (GPIO0)
ROW1: D20.2 (A), D21.1 (K), D22.2 (A), D23.1 (K), D24.1 (K), D25.2 (A), D26.1 (K), D27.2 (A), D28.1 (K), D29.2 (A), D30.1 (K), D31.2 (A), D32.1 (K), D33.2 (A), D34.1 (K), D35.2 (A), D36.1 (K), D37.2 (A), D38.1 (K), D113.2 (A), U4.12 (GPIO9)
ROW2: D39.2 (A), D40.1 (K), D41.2 (A), D42.1 (K), D43.1 (K), D44.2 (A), D45.1 (K), D46.2 (A), D47.1 (K), D48.2 (A), D49.1 (K), D50.2 (A), D51.1 (K), D52.2 (A), D53.1 (K), D54.2 (A), D55.1 (K), D56.2 (A), D57.1 (K), D112.2 (A), U4.13 (GPIO10)
ROW3: D58.1 (K), D59.2 (A), D60.1 (K), D61.2 (A), D62.1 (K), D63.2 (A), D64.1 (K), D65.2 (A), D66.1 (K), D67.2 (A), D68.1 (K), D69.2 (A), D70.1 (K), D71.2 (A), D72.1 (K), D73.2 (A), D74.1 (K), D75.1 (K), U4.14 (GPIO11)
ROW4: D76.2 (A), D77.1 (K), D78.2 (A), D79.1 (K), D80.1 (K), D81.1 (K), D82.2 (A), D83.1 (K), D84.2 (A), D85.1 (K), D86.2 (A), D87.1 (K), D88.2 (A), D89.1 (K), D90.2 (A), D91.1 (K), D92.1 (K), D93.2 (A), D94.2 (A), D115.1 (K), U4.15 (GPIO12)
ROW5: D95.1 (K), D96.2 (A), D97.2 (A), D98.1 (K), D99.1 (K), D100.1 (K), D101.1 (K), D102.1 (K), D103.2 (A), D104.1 (K), D105.2 (A), D106.1 (K), D107.2 (A), D108.1 (K), D109.1 (K), D110.2 (A), D111.1 (K), U4.16 (GPIO13)
SWC: TP6.1, U4.24 (SWCLK)
SWD: TP7.1, U4.25 (SWD)
VBUS: F1.1, J1.A4 (VBUS), J1.A9 (VBUS), J1.B4 (VBUS), J1.B9 (VBUS), TP1.1
XIN: C11.2, U4.20 (XIN), Y1.3
XOUT: R8.1, U4.21 (XOUT)

Notes on the sheet:
TEST POINTS
Encoders
LED Decoupling
Takes 3v LED signal and upshifts to 5V
Crystal
FLASH
USB Input
LED Level Shifter
Display
NOTE: When USB=500mA, select Rlim = 75k = 74.25k @ 1% = 319mA-401mA range
M2 Mounting Holes
NOTE: Capacitor placed at branching points of LED PWR
RP2040
Switch & LED Matrix
LED Power
RESET & BOOT
3.3V Regulator
