printsmith/Greenwood18N2/(commit log)

2023-11-25 Initial commit of KiCAD project
    [Greenwood18N2.kicad_sch, b2f16a65f4e9bf5dfcba937e58a7501a033d6607_switch.dxf]
2023-11-25 Add .pretty for KiCAD
    - _mod files added
    - 3D models added
    - update keyboard name in schematics to match
    [Greenwood18N2.kicad_sch]
2023-11-27 Current Limiter update
    add in an RC delay circuit for the EN pin of the TPS2553 current limiter. This should allow the USB to handshake and configure itself and the allow the current limiter to then start working.
    [Greenwood18N2.kicad_sch]
2023-11-27 Rework of encoders
    Remove the dual LED, switch and encoder footprints, it was too complex and I want encoders, I will never be using them as just mx switches.
    Changed the encoder under the LCD to an EVQWGD001 since it wont block the screen and be easier to use with just your index finger.
    [Greenwood18N2.kicad_sch]
2023-11-28 Add reset switch
    [Greenwood18N2.kicad_sch]
2023-11-28 Update name
    [SP110Duo.kicad_sch, b2f16a65f4e9bf5dfcba937e58a7501a033d6607_switch.dxf]
2023-12-18 change name
    [SP110Duo.kicad_sch, plate-2023-11-30T22_32_08.672Z.dxf, plate.dxf]
2024-01-11 Revert "update"
    This reverts commit 5ff72173e5904ec7ac0860fae9239c8bb0f8e9f6.
    [RGB_layout.ods, SP110Duo_v2.kicad_pro.kicad_sch, b2f16a65f4e9bf5dfcba937e58a7501a033d6607_switch.dxf, plate-2023-11-30T22_32_08.672Z.dxf, plate.dxf]
2024-01-12 Update diode directions
    Correct diode direction so that columns are not reversed in software.
    [SP110Duo.kicad_sch]
2024-01-15 Fix crossed pins for display
    Update so that SPI pins are in correct place
    [SP110Duo.kicad_sch]
2024-01-26 Merge RGB EN and LCD VCC
    Now RGB EN pin controls both RGB and LCD. This is due to lack of GPIO and a want to turn off the LCD when the keyboard goes to sleep.
    [SP110Duo.kicad_sch]
2024-01-26 Change LCD power to LED power signal
    [SP110Duo.kicad_sch]
2024-01-26 Add RC delay for LED current limiter
    Changing the GPIO for LED enable to only enable the LCD screen. Switching the current limiter enable to an RC delay circuit.
    [SP110Duo.kicad_sch]
2024-01-26 update footprints
    [SP110Duo.kicad_sch]
2024-01-30 Modify diode footprint, add LCD PWR circuit
    [SP110Duo.kicad_sch]
2024-01-31 Update decoupling
    [SP110Duo.kicad_sch]
2024-02-01 add footprints for LCDs
    add autosave to gitignore
    [SP110Duo.kicad_sch]
2024-02-07 PCB rev01 update
    [SP110Duo.kicad_sch]
2024-02-07 Align schematic to PCB
    [SP110Duo.kicad_sch]
2024-02-08 update LED pwr tracks
2024-02-10 add gnd vias
2024-02-12 update traces
    [SP110Duo.kicad_sch]
2024-02-13 update reset pin trace
2024-02-13 Overhaul File structure
    [SP110Duo.kicad_sch, b2f16a65f4e9bf5dfcba937e58a7501a033d6607_switch.dxf, plate-2023-11-30T22_32_08.672Z.dxf, plate.dxf]
2024-02-17 RP2040 based rev2
    Add integrated MCU to board, RP2040 with all supporting hardware
    [SP110Duo.kicad_sch, b2f16a65f4e9bf5dfcba937e58a7501a033d6607_switch.dxf]
2024-02-17 schematic layout update
    [SP110Duo.kicad_sch]
2024-02-18 update dev board circuit
2024-02-19 update rp2040 version
    [SP110Duo.kicad_sch]
2024-02-24 Massive update
    Joystick encoder added to next version to replace encoder 2 above left nav cluster
    [SP110Duo.kicad_sch, b2f16a65f4e9bf5dfcba937e58a7501a033d6607_switch.dxf, plate-2023-11-30T22_32_08.672Z.dxf, plate.dxf]
2024-06-13 update repo organization
    [SP110Duo.kicad_sch, b2f16a65f4e9bf5dfcba937e58a7501a033d6607_switch.dxf, plate-2023-11-30T22_32_08.672Z.dxf, plate.dxf]
